DuhBrain/ECE-298/diptrace/F2019_ECE-298_Components/F2019_ECE-298_Components/3d_Models/E298_to-92.step

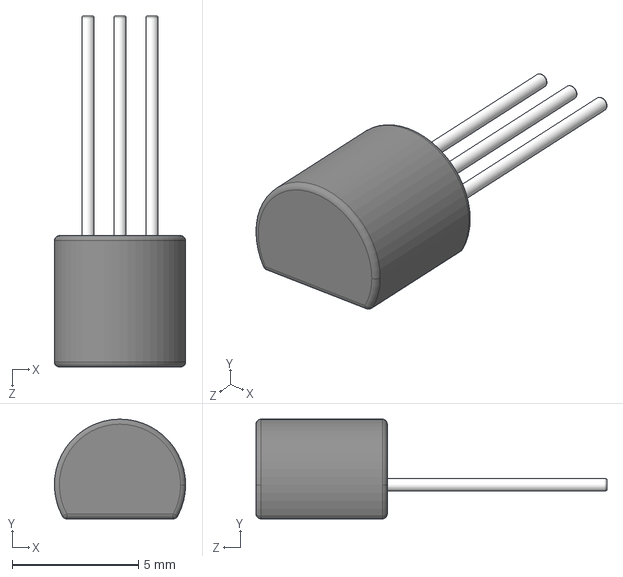
[picture p8: CAD file, 2019-11-01]
diptrace/F2019_ECE-298_Components/F2019_ECE-298_Components/3d_Models/E298_to-92.step
5.20 x 3.95 x 13.9 mm
