DuhBrain/ECE-298/diptrace/F2019_ECE-298_Components/F2019_ECE-298_Components/3d_Models/E298_sop-4_4.85x1.27.step

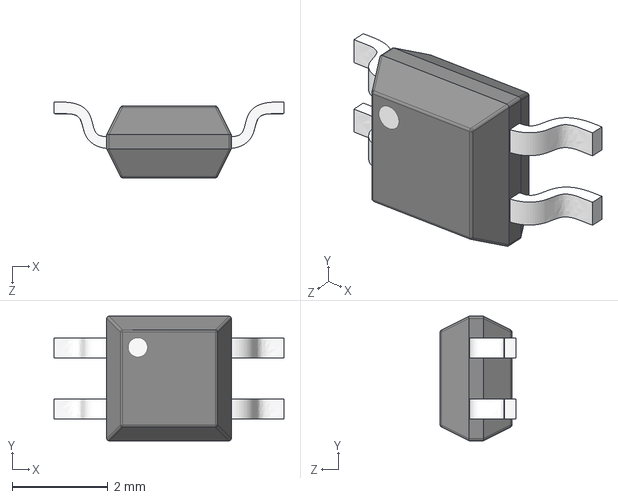
[picture p9: CAD file, 2019-11-01]
diptrace/F2019_ECE-298_Components/F2019_ECE-298_Components/3d_Models/E298_sop-4_4.85x1.27.step
4.80 x 2.60 x 1.58 mm
sop-4_4.85x1.27
sop-4_4.85x1.27_001
