DuhBrain/ECE-298/diptrace/F2019_ECE-298_Components/F2019_ECE-298_Components/3d_Models/E298_EM-6022P.step

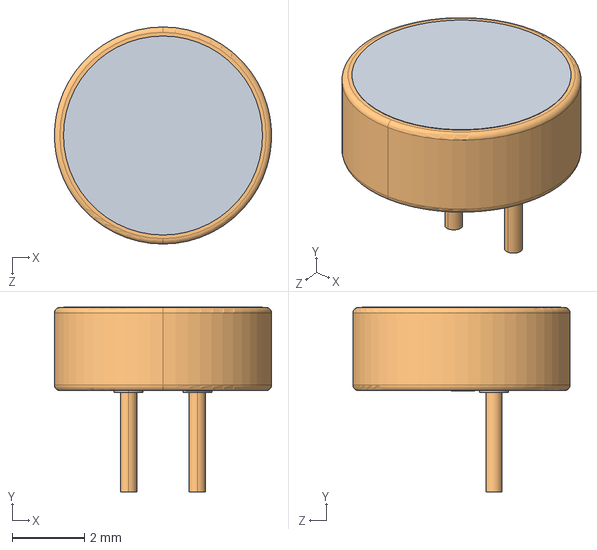
[picture p10: CAD file, 2019-11-01]
diptrace/F2019_ECE-298_Components/F2019_ECE-298_Components/3d_Models/E298_EM-6022P.step
6.00 x 5.11 x 6.00 mm
