DuhBrain/ECE-298/diptrace/F2019_ECE-298_Components/F2019_ECE-298_Components/3d_Models/E298_do-41.step

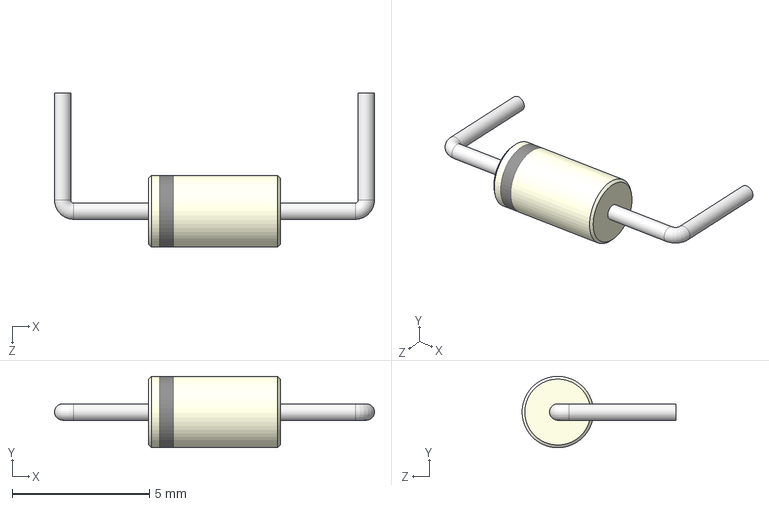
[picture p11: CAD file, 2019-11-01]
diptrace/F2019_ECE-298_Components/F2019_ECE-298_Components/3d_Models/E298_do-41.step
11.6 x 2.60 x 5.60 mm
