DuhBrain/ECE-298/diptrace/F2019_ECE-298_Components/F2019_ECE-298_Components/3d_Models/E298_led-5r_yellow.step

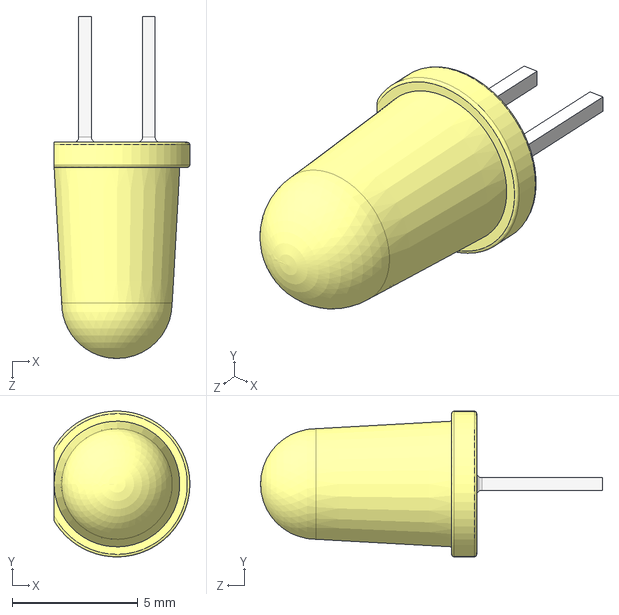
[picture p15: CAD file, 2019-11-01]
diptrace/F2019_ECE-298_Components/F2019_ECE-298_Components/3d_Models/E298_led-5r_yellow.step
5.40 x 5.80 x 13.6 mm
