DuhBrain/ECE-298/diptrace/F2019_ECE-298_Components/F2019_ECE-298_Components/3d_Models/E298_sip-3_4.58x1.55x1.27.step

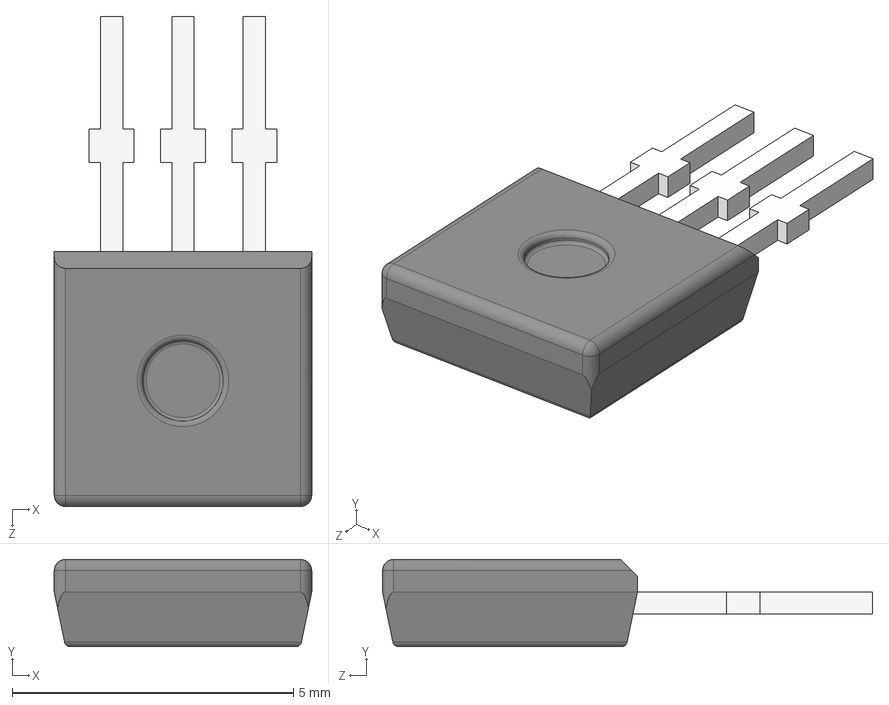
[picture p17: CAD file, 2019-11-01]
diptrace/F2019_ECE-298_Components/F2019_ECE-298_Components/3d_Models/E298_sip-3_4.58x1.55x1.27.step
4.58 x 1.55 x 8.71 mm
