DuhBrain/ECE-298/diptrace/F2019_ECE-298_Components/F2019_ECE-298_Components/3d_Models/E298_hdrf-1x2t_2.54_6x3.step

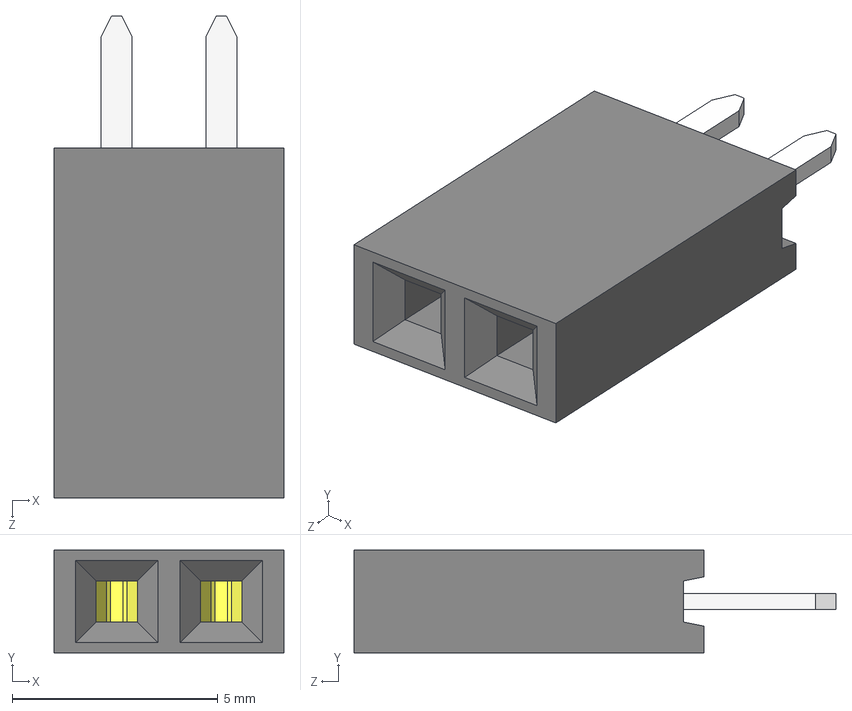
[picture p18: CAD file, 2019-11-01]
diptrace/F2019_ECE-298_Components/F2019_ECE-298_Components/3d_Models/E298_hdrf-1x2t_2.54_6x3.step
5.58 x 2.50 x 11.7 mm
