DuhBrain/ECE-298/diptrace/F2019_ECE-298_Components/F2019_ECE-298_Components/3d_Models/E298_soic-16_150mil.step

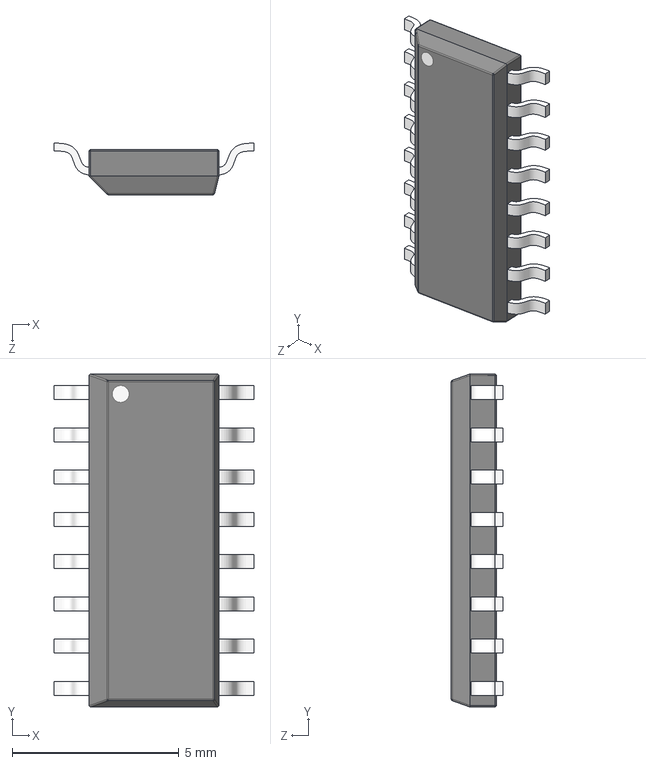
[picture p19: CAD file, 2019-11-01]
diptrace/F2019_ECE-298_Components/F2019_ECE-298_Components/3d_Models/E298_soic-16_150mil.step
6.00 x 10.0 x 1.55 mm
soic-16_150mil
soic-16_150mil_001
