DuhBrain/ECE-298/diptrace/F2019_ECE-298_Components/F2019_ECE-298_Components/3d_Models/E298_sot23.step

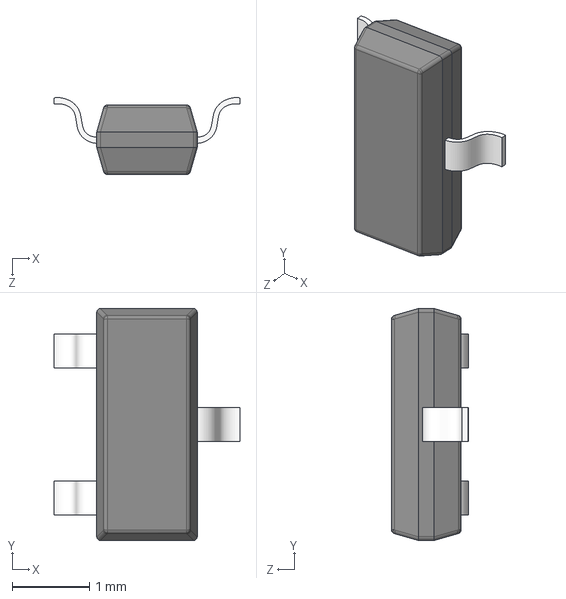
[picture p20: CAD file, 2019-11-01]
diptrace/F2019_ECE-298_Components/F2019_ECE-298_Components/3d_Models/E298_sot23.step
2.40 x 3.00 x 0.996 mm
sot23
sot23_001
