DuhBrain/ECE-298/diptrace/F2019_ECE-298_Components/F2019_ECE-298_Components/3d_Models/E298_EM-9745P-1.step

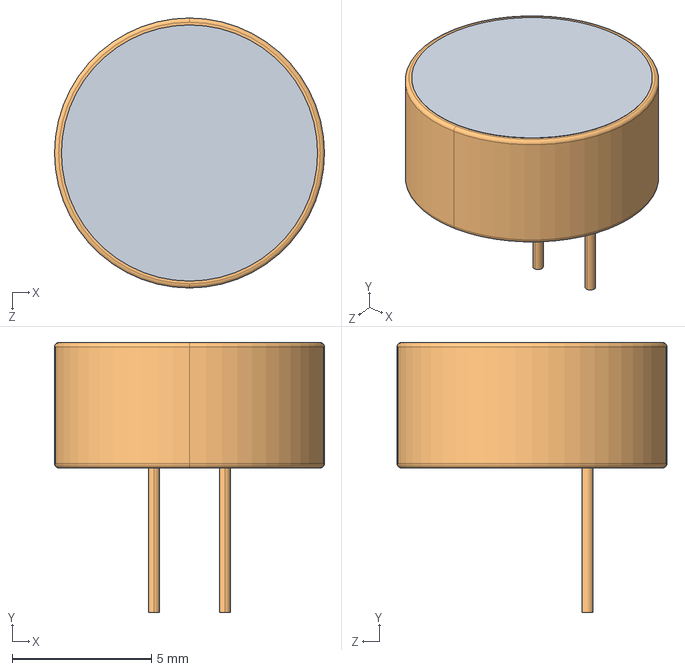
[picture p21: CAD file, 2019-11-01]
diptrace/F2019_ECE-298_Components/F2019_ECE-298_Components/3d_Models/E298_EM-9745P-1.step
9.70 x 9.71 x 9.70 mm
