DuhBrain/ECE-298/diptrace/F2019_ECE-298_Components/F2019_ECE-298_Components/3d_Models/E298_cap-2.54_3.18x3.18.step

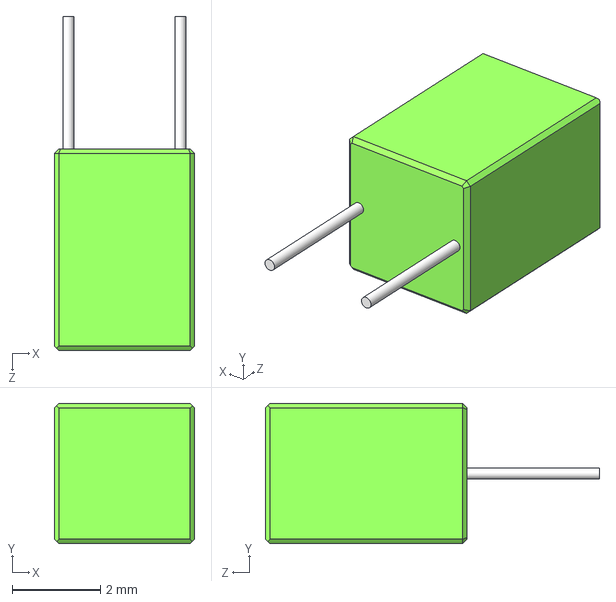
[picture p22: CAD file, 2019-11-01]
diptrace/F2019_ECE-298_Components/F2019_ECE-298_Components/3d_Models/E298_cap-2.54_3.18x3.18.step
3.18 x 3.18 x 7.57 mm
