DuhBrain/ECE-298/diptrace/F2019_ECE-298_Components/F2019_ECE-298_Components/3d_Models/E298_hdrf-1x3t_2.54_8x3.step

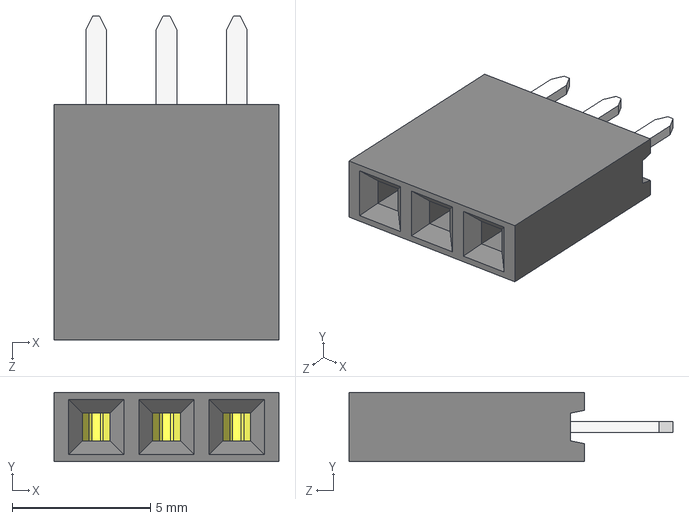
[picture p23: CAD file, 2019-11-01]
diptrace/F2019_ECE-298_Components/F2019_ECE-298_Components/3d_Models/E298_hdrf-1x3t_2.54_8x3.step
8.12 x 2.50 x 11.7 mm
