DuhBrain/ECE-298/diptrace/F2019_ECE-298_Components/F2019_ECE-298_Components/3d_Models/E298_sot23-6.step

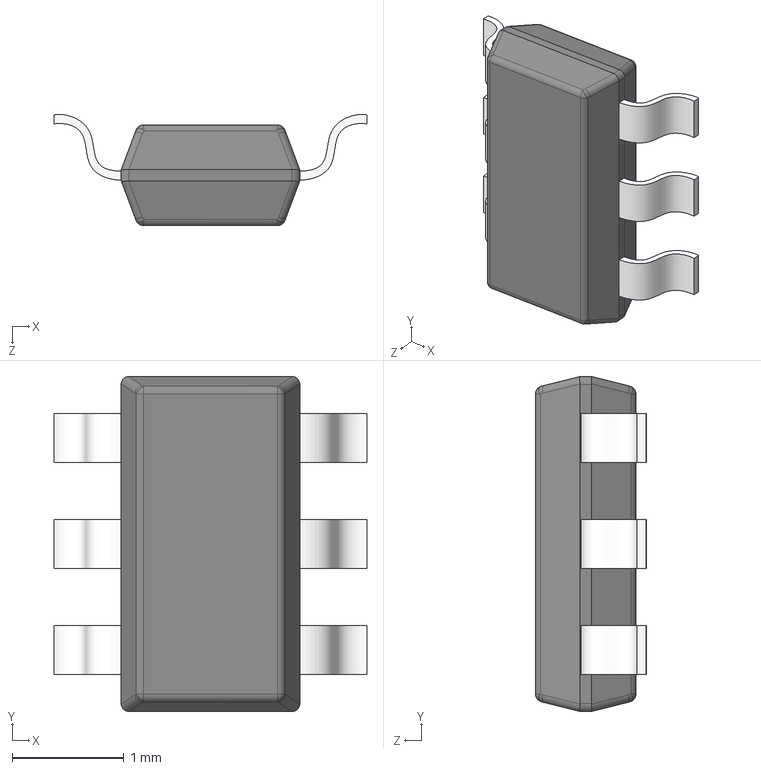
[picture p28: CAD file, 2019-11-01]
diptrace/F2019_ECE-298_Components/F2019_ECE-298_Components/3d_Models/E298_sot23-6.step
2.80 x 3.00 x 0.995 mm
sot23-6
sot23-6_001
