DuhBrain/ECE-298/diptrace/F2019_ECE-298_Components/F2019_ECE-298_Components/3d_Models/E298_ssop-24_7.6x0.65.step

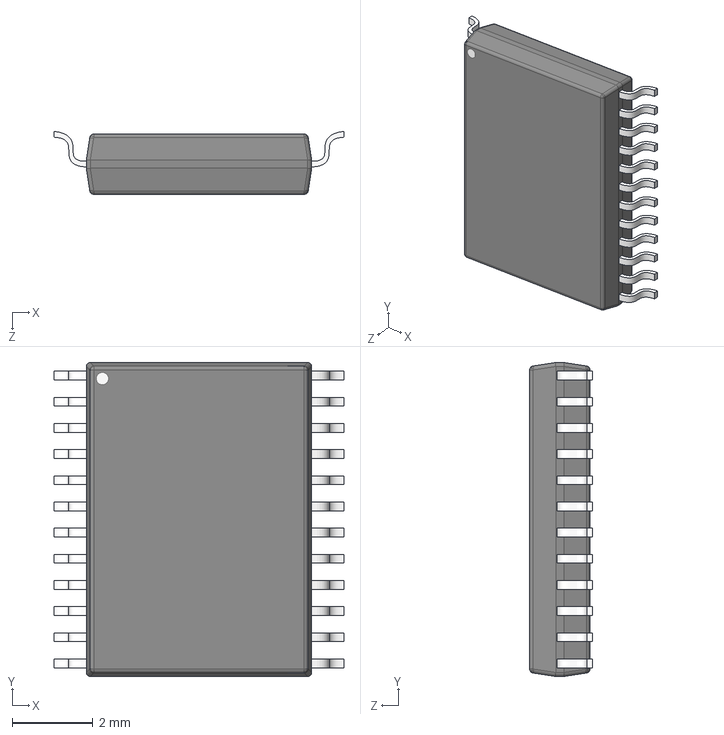
[picture p31: CAD file, 2019-11-01]
diptrace/F2019_ECE-298_Components/F2019_ECE-298_Components/3d_Models/E298_ssop-24_7.6x0.65.step
7.20 x 7.80 x 1.56 mm
sop-24_7.6x0.65
sop-24_7.6x0.65_001
