DuhBrain/ECE-298/diptrace/F2019_ECE-298_Components/F2019_ECE-298_Components/3d_Models/E298_soic-8_150mil.step

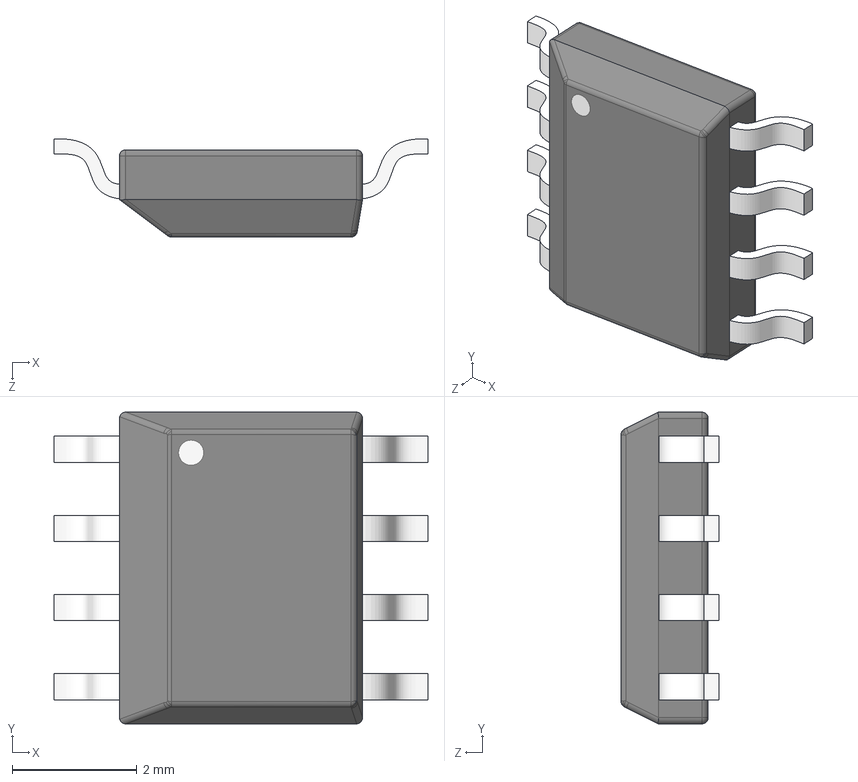
[picture p34: CAD file, 2019-11-01]
diptrace/F2019_ECE-298_Components/F2019_ECE-298_Components/3d_Models/E298_soic-8_150mil.step
6.00 x 5.00 x 1.58 mm
soic-8_150mil
soic-8_150mil_001
