DuhBrain/ECE-298/(list of files, cad)

Other CAD files:
diptrace/F2019_ECE-298_Components/F2019_ECE-298_Components/3d_Models/E298_led-3r_yellow.step
diptrace/F2019_ECE-298_Components/F2019_ECE-298_Components/3d_Models/E298_led-5r_blue.step
diptrace/F2019_ECE-298_Components/F2019_ECE-298_Components/3d_Models/E298_led-5r_red.step
diptrace/F2019_ECE-298_Components/F2019_ECE-298_Components/3d_Models/E298_sot23-5.step
diptrace/F2019_ECE-298_Components/F2019_ECE-298_Components/3d_Models/E298_led-5r_green.step
diptrace/F2019_ECE-298_Components/F2019_ECE-298_Components/3d_Models/E298_led-3r_red.step
diptrace/F2019_ECE-298_Components/F2019_ECE-298_Components/3d_Models/E298_led-3r_blue.step
