DuhBrain/ECE-298/(list of files, drawings)

Other design files:
diptrace/greenhouse_schem_gr4_section5.dch
diptrace/layout_section5_group4.dip
