DuhBrain/ECE-298/(commit log)

2019-09-16 Created Template Project LED_BLINKER for reference, will likely delete at some point
2019-09-24 fixed motor bug
2019-10-05 diptrace libraries and rule files
    [E298_EM-6022P.step, E298_EM-9745P-1.step, E298_TC-33X-2.step, E298__capo-2.54_3.05x1.78.step, E298_aom-6545p.step, E298_b3fs.step, E298_cap-2.54_3.18x3.18.step, E298_cap_0805.step]
2019-10-05 added gitignore and base schem will all the settings
    [greenhouse_schem.dch]
2019-10-05 initial schem set up with nets and pages
    [greenhouse_schem.dch]
2019-10-07 created motor logic page
    [greenhouse_schem.dch]
2019-10-08 updated motor logic, added 5V connector
    [greenhouse_schem.dch]
2019-10-09 assigned unused to NC
    [greenhouse_schem.dch]
2019-10-10 rule check, checked net classes, added LEDs
    [greenhouse_schem.dch]
2019-10-27 added level shifter, made single-sheet design, added cap to U3
    [greenhouse_schem.dch]
2019-10-27 added PWM_5V net class to DIGTAL Signals
    [greenhouse_schem.dch]
2019-10-29 added LV pin to 3V3 net
    [greenhouse_schem.dch]
2019-10-30 connected all wires to appropriate nets/net classes; added local decoupling caps to level shifter connectors; updated mux vcc to use 5V0; updated bom
    [greenhouse_schem.dch]
2019-10-31 added layout ad setup
    [greenhouse_schem.dch, layout_section5_group4.dip]
2019-10-31 motor logic layout
    [layout_section5_group4.dip]
2019-10-31 layout caps and leds done
    [layout_section5_group4.dip]
2019-11-01 decoupling cap on 3v3 from board
    [greenhouse_schem.dch, layout_section5_group4.dip]
2019-11-01 updated leds
    [greenhouse_schem.dch, layout_section5_group4.dip]
2019-11-01 i only changed the schematic to add decoupling caps to motor pins, idk where all these other file changes are coming from
    [BOM_1.csv, E298_EM-6022P.step, E298_EM-9745P-1.step, E298_TC-33X-2.step, E298__capo-2.54_3.05x1.78.step, E298_aom-6545p.step, E298_b3fs.step, E298_cap-2.54_3.18x3.18.step]
2019-11-10 ADC multiplexing and interrupts for PB
    [greenhouse_schem_gr4_section5.dch, layout_section5_group4.dip]
2019-11-12 zone switching PB, motor control w/ interrupts, temperature averaging, multiple zones, output configured but not tested
2019-11-18 added motor logic
2019-11-19 sensor testing with PCB
2019-11-19 basically i know what i have to do for uart i just have to do it lmao
2019-11-21 4 motors w pcb
2019-11-21 4 motors w pcb rm commented blocks
2019-11-21 added UART logic
2019-11-21 finished uart
